danwchan/openplant_incubator/(list of files, drawings)

Other design files:
liverwort_incubator_v1.fzz
liverwort_incubator_v2.fzz
