danwchan/openplant_incubator/Test_data/BwoB_incubator_v2/Revamped_code/data_cleanup.html

# Analyzing the performance of the OpenPlant incubator at Genspace

- Read in data and preprocess
- Visualze the data

sessionInfo() #for reproducibility

## R version 3.5.1 (2018-07-02)
## Platform: x86_64-redhat-linux-gnu (64-bit)
## Running under: Fedora 28 (Twenty Eight)
## 
## Matrix products: default
## BLAS/LAPACK: /usr/lib64/R/lib/libRblas.so
## 
## locale:
##  [1] LC_CTYPE=en_CA.UTF-8       LC_NUMERIC=C              
##  [3] LC_TIME=en_CA.UTF-8        LC_COLLATE=en_CA.UTF-8    
##  [5] LC_MONETARY=en_CA.UTF-8    LC_MESSAGES=en_CA.UTF-8   
##  [7] LC_PAPER=en_CA.UTF-8       LC_NAME=C                 
##  [9] LC_ADDRESS=C               LC_TELEPHONE=C            
## [11] LC_MEASUREMENT=en_CA.UTF-8 LC_IDENTIFICATION=C       
## 
## attached base packages:
## [1] stats     graphics  grDevices utils     datasets  methods   base     
## 
## other attached packages:
## [1] rmarkdown_1.11 knitr_1.21     bindrcpp_0.2.2 zoo_1.8-4     
## [5] ggplot2_3.1.0  stringr_1.3.1  tidyr_0.8.2    dplyr_0.7.8   
## [9] readr_1.3.1   
## 
## loaded via a namespace (and not attached):
##  [1] Rcpp_1.0.0       highr_0.7        pillar_1.3.1     compiler_3.5.1  
##  [5] plyr_1.8.4       bindr_0.1.1      tools_3.5.1      digest_0.6.18   
##  [9] evaluate_0.12    tibble_2.0.1     gtable_0.2.0     lattice_0.20-35 
## [13] pkgconfig_2.0.2  rlang_0.3.1      yaml_2.2.0       xfun_0.4        
## [17] withr_2.1.2      hms_0.4.2        grid_3.5.1       tidyselect_0.2.5
## [21] glue_1.3.0       R6_2.3.0         purrr_0.3.0      reshape2_1.4.3  
## [25] magrittr_1.5     htmltools_0.3.6  scales_1.0.0     assertthat_0.2.0
## [29] colorspace_1.4-0 labeling_0.3     stringi_1.2.4    lazyeval_0.2.1  
## [33] munsell_0.5.0    crayon_1.3.4

# Read in data and preprocess

Declare the labels for the columns and list the files which will be read into the data table. Then prep the master data table as tidy data.

labels <- c("time", "temp", "humidity", "lux", "input", "fan", "output") #comment out this line for the updated code since fan and input are removed from the code
labels <- c("time", "temp", "humidity", "lux", "output")
setwd("./BwoB_incubator_v2/Revamped_code/")
files <- c("190124.LOG",
           "190125.LOG",
           "190126.LOG")

working_data <- lapply(files, read_csv, col_names = labels) %>%
  bind_rows() %>%
  transform(time = as.POSIXct(strptime(time, "%Y%m%d_%H:%M:%S"))) %>%
#  select(-input, -fan) %>% #comment out this line for the updated code since fan and input are removed from the code
  gather(measure, value, -time) %>%
  arrange(time, measure)

# Visualze the data

plot the measures

ggplot(data = working_data, aes(x = time, y = value)) +
  #scale_color_brewer(palette = "Set1") +
  geom_line() +
  #geom_line(aes(alpha = 0.5)) +
  #geom_line(aes(x = rollmean(time, 3, fill = NA), y = rollmean(value, 3, fill = NA), colour = measure)) +
  facet_grid(measure ~ ., scales = "free_y")

ggplot(data = filter(working_data, format(time, "%m%d") == "0125"), aes(x = time, y = value)) +
  geom_line() +
  facet_grid(measure ~ ., scales = "free_y")

zoom into the interesting features on January 25

The PID constants are off it reaches maximum too quickly
