danwchan/openplant_incubator/Test_data/Genspace_incubator_v1/data_cleanup.html

# Analyzing the performance of the OpenPlant incubator at Genspace

- Read in data and preprocess
- Visualze the data

sessionInfo() #for reproducibility

## R version 3.5.0 (2018-04-23)
## Platform: x86_64-redhat-linux-gnu (64-bit)
## Running under: Fedora 27 (Twenty Seven)
## 
## Matrix products: default
## BLAS/LAPACK: /usr/lib64/R/lib/libRblas.so
## 
## locale:
##  [1] LC_CTYPE=en_CA.UTF-8       LC_NUMERIC=C              
##  [3] LC_TIME=en_CA.UTF-8        LC_COLLATE=en_CA.UTF-8    
##  [5] LC_MONETARY=en_CA.UTF-8    LC_MESSAGES=en_CA.UTF-8   
##  [7] LC_PAPER=en_CA.UTF-8       LC_NAME=C                 
##  [9] LC_ADDRESS=C               LC_TELEPHONE=C            
## [11] LC_MEASUREMENT=en_CA.UTF-8 LC_IDENTIFICATION=C       
## 
## attached base packages:
## [1] stats     graphics  grDevices utils     datasets  methods   base     
## 
## other attached packages:
## [1] ggplot2_3.0.0  stringr_1.3.1  tidyr_0.8.1    dplyr_0.7.6   
## [5] readr_1.1.1    rmarkdown_1.10 knitr_1.20    
## 
## loaded via a namespace (and not attached):
##  [1] Rcpp_0.12.17     bindr_0.1.1      magrittr_1.5     hms_0.4.2       
##  [5] munsell_0.5.0    tidyselect_0.2.4 colorspace_1.3-2 R6_2.2.2        
##  [9] rlang_0.2.1      plyr_1.8.4       tools_3.5.0      grid_3.5.0      
## [13] gtable_0.2.0     withr_2.1.2      htmltools_0.3.6  lazyeval_0.2.1  
## [17] yaml_2.1.19      rprojroot_1.3-2  digest_0.6.15    assertthat_0.2.0
## [21] tibble_1.4.2     bindrcpp_0.2.2   purrr_0.2.5      glue_1.2.0      
## [25] evaluate_0.10.1  stringi_1.2.3    compiler_3.5.0   pillar_1.2.3    
## [29] scales_0.5.0     backports_1.1.2  pkgconfig_2.0.1

# Read in data and preprocess

Declare the labels for the columns and list the files which will be read into the data table. Then prep the master data table as tidy data.

labels <- c("time", "temp", "humidity", "lux", "input", "fan", "output")
files <- c("180703.LOG", "180704.LOG", "180705.LOG", "180706.LOG","180707.LOG", "180708.LOG", "180709.LOG", "180710.LOG")

working_data <- lapply(files, read_csv, col_names = labels) %>%
  bind_rows() %>%
  transform(time = as.POSIXct(strptime(time, "%Y%m%d_%H:%M:%S"))) %>%
  select(-input, -fan) %>%
  gather(measure, value, -time) %>%
  arrange(time, measure)

# Visualze the data

plot the measures

ggplot(data = working_data, aes(x = time, y = value)) +
  #scale_color_brewer(palette = "Set1") +
  geom_line() +
  #geom_line(aes(alpha = 0.5)) +
  #geom_line(aes(x = rollmean(time, 3, fill = NA), y = rollmean(value, 3, fill = NA), colour = measure)) +
  facet_grid(measure ~ ., scales = "free_y")

ggplot(data = filter(working_data, format(time, "%m%d") == "0707"), aes(x = time, y = value)) +
  geom_line() +
  facet_grid(measure ~ ., scales = "free_y")

zoom into the interesting features on July 7
