danwchan/openplant_incubator/(commit log)

2018-12-31 updating the code to a state based version starting with the unit tests
    [liverwort_incubator_v1.fzz]
2019-01-03 update the lux sensor to a state based version
2019-01-03 trying to create a feedback with the light sensor and led strip
2019-01-04 mostly working except the after the lights turn back on it blows out the sensor
2019-01-04 clean up this merge cruff
    [liverwort_incubator_v1_LOCAL_32405.fzz]
2019-01-04 fix the autogain and set the test to a liverwort lux level
    [test_lights.ino]
2019-01-10 fix a typo in the humidity variable assignment
    [test_temp.ino]
2019-01-16 the PID doesn't compute...
    [test_temp_control.ino]
2019-01-16 fixed by adding a separate call to SetTunings in configure
    [test_temp_control.ino]
2019-01-19 fix the night mode toggle
    [test_lights.ino]
2019-01-19 add in the relay for switching the polarity of the peltier
2019-01-19 adjust the test scripts to remove floating pins introduced by the relay
2019-01-22 fix up the comments in the code
    [prototype_incubator_v2.ino]
2019-01-22 update the version 1 fritzing board
    [liverwort_incubator_v1.fzz]
2019-01-22 the new wiring diagram for the updated incubator
    [liverwort_incubator_v2.fzz]
2019-01-28 some info about a power supply gained with a multimeter
2019-01-28 update control script after failure with runaway heating
    [prototype_incubator_v2.ino, test_temp_control.ino]
